Hsgngr/skygangsters-cad/previews/02_open_rear.png

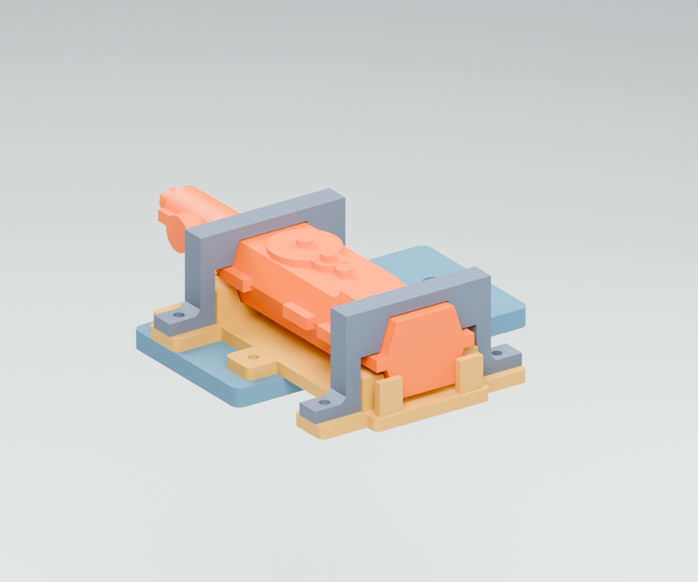
previews/02_open_rear.png
