Hsgngr/skygangsters-cad/previews/03_carrier_exploded.png

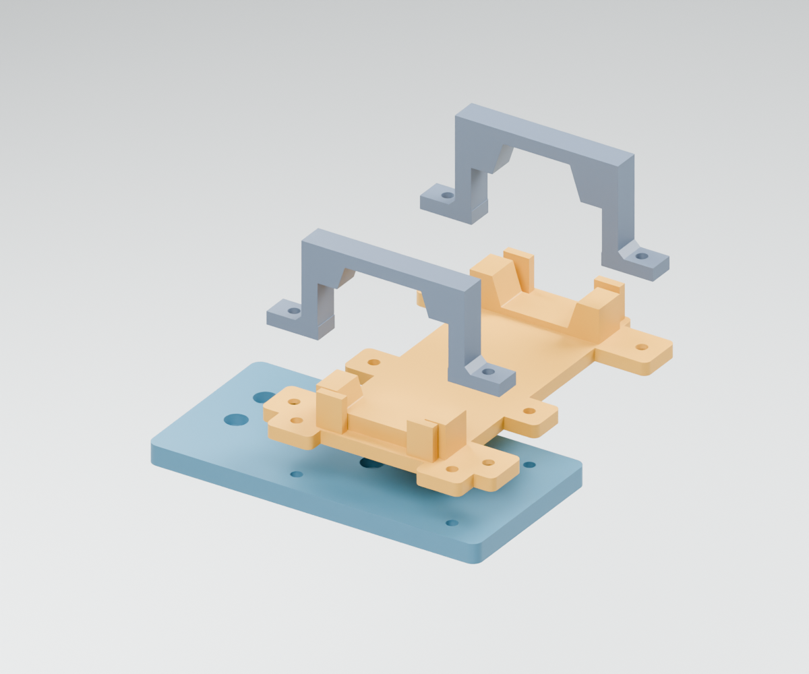
previews/03_carrier_exploded.png
