Hsgngr/skygangsters-cad/cad/latest/carrier_v4/assembly/front_bridge_assembly.stl

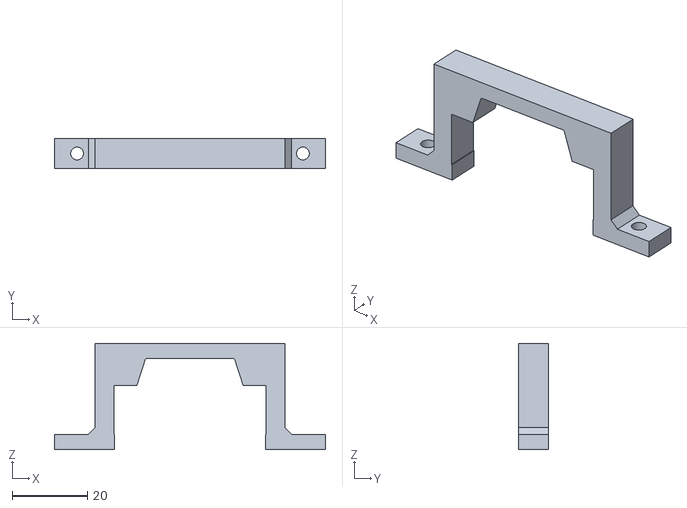
[picture p4: CAD file, 2026-09-30]
cad/latest/carrier_v4/assembly/front_bridge_assembly.stl
72.0 x 8.00 x 28.2
