Hsgngr/skygangsters-cad/cad/latest/carrier_v4/assembly/ptz_adapter_assembly.stl

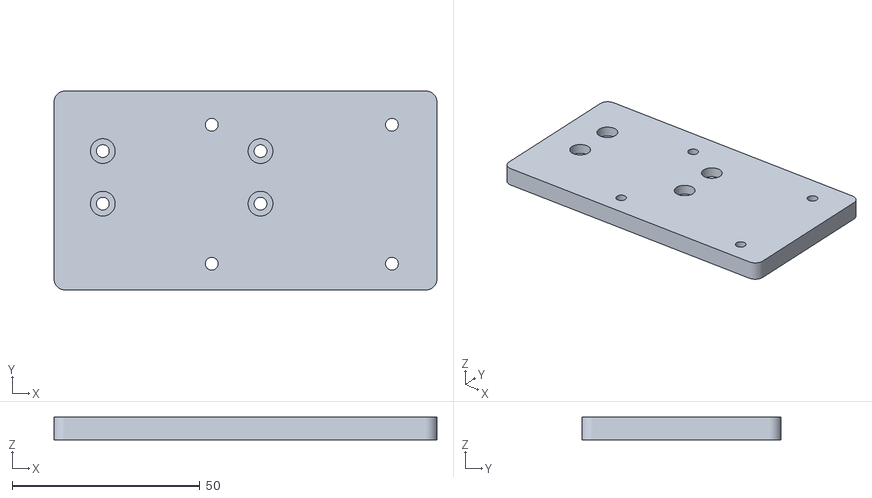
[picture p6: CAD file, 2026-09-30]
cad/latest/carrier_v4/assembly/ptz_adapter_assembly.stl
102.0 x 53.0 x 6.00
