Hsgngr/skygangsters-cad/cad/latest/carrier_v4/assembly/front_fit_saddle_assembly.stl

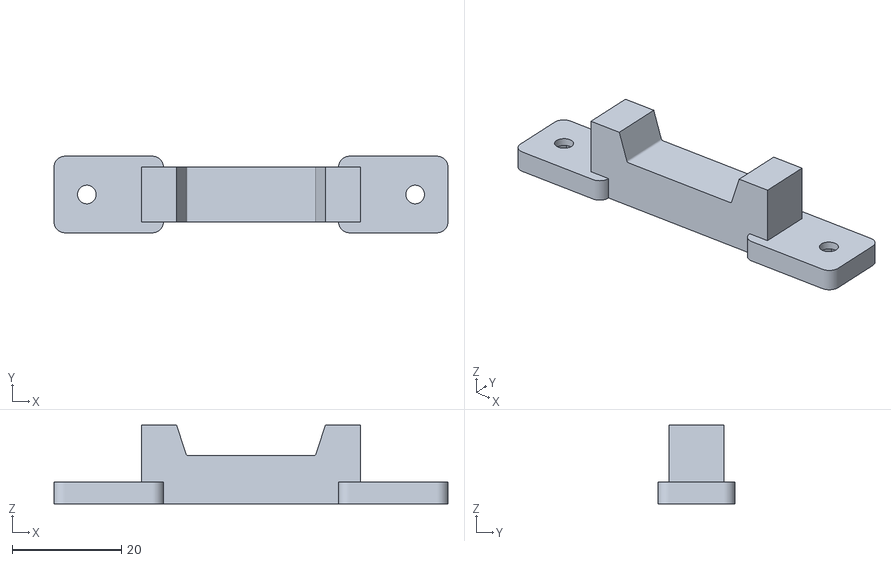
[picture p8: CAD file, 2026-09-30]
cad/latest/carrier_v4/assembly/front_fit_saddle_assembly.stl
72.0 x 14.0 x 14.4
