Hsgngr/skygangsters-cad/cad/latest/carrier_v4/assembly/gun_deck_assembly.stl

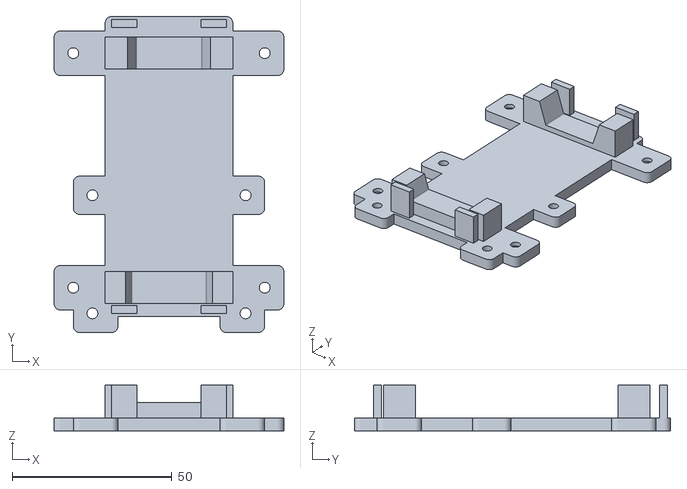
[picture p9: CAD file, 2026-09-30]
cad/latest/carrier_v4/assembly/gun_deck_assembly.stl
72.0 x 99.1 x 14.4
