Hsgngr/skygangsters-cad/cad/references/water_pump/water_pump.step

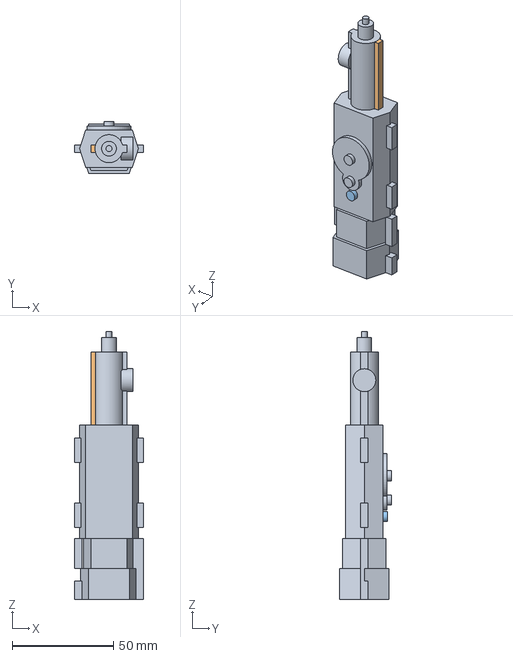
[picture p10: CAD file, 2026-09-30]
cad/references/water_pump/water_pump.step
34.0 x 25.4 x 132.1 mm
