Hsgngr/skygangsters-cad/cad/latest/carrier_v4/assembly/user_pump_body_2_reference.stl

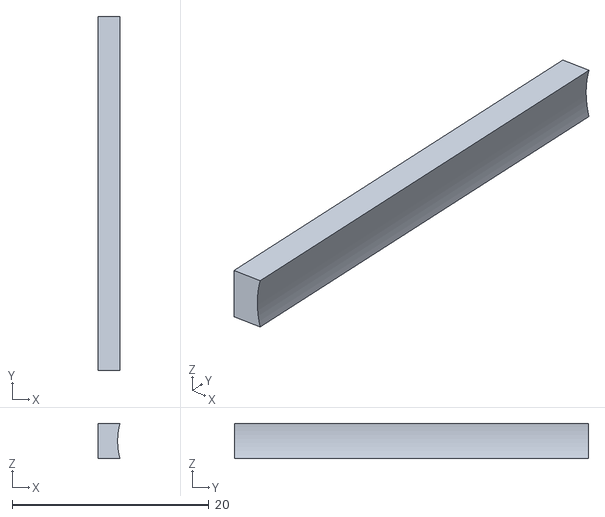
[picture p11: CAD file, 2026-09-30]
cad/latest/carrier_v4/assembly/user_pump_body_2_reference.stl
2.24 x 36.0 x 3.60
