Hsgngr/skygangsters-cad/print/coupons/ptz_top_pattern_test.stl

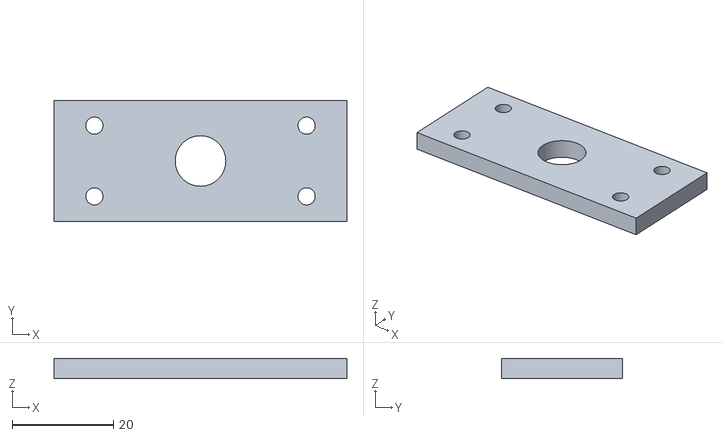
[picture p12: CAD file, 2026-09-29]
print/coupons/ptz_top_pattern_test.stl
58.0 x 24.0 x 4.00
