Hsgngr/skygangsters-cad/print/coupons/camera_hole_pattern_test.stl

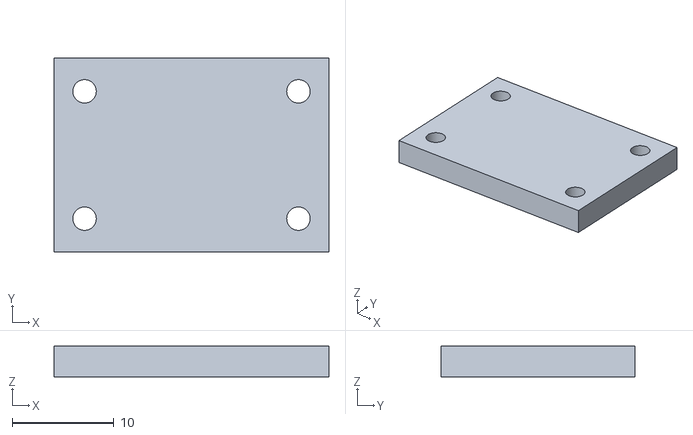
[picture p13: CAD file, 2026-09-29]
print/coupons/camera_hole_pattern_test.stl
27.0 x 19.0 x 3.00
