Hsgngr/skygangsters-cad/cad/latest/carrier_v4/assembly/ptz_tilt_reference.stl

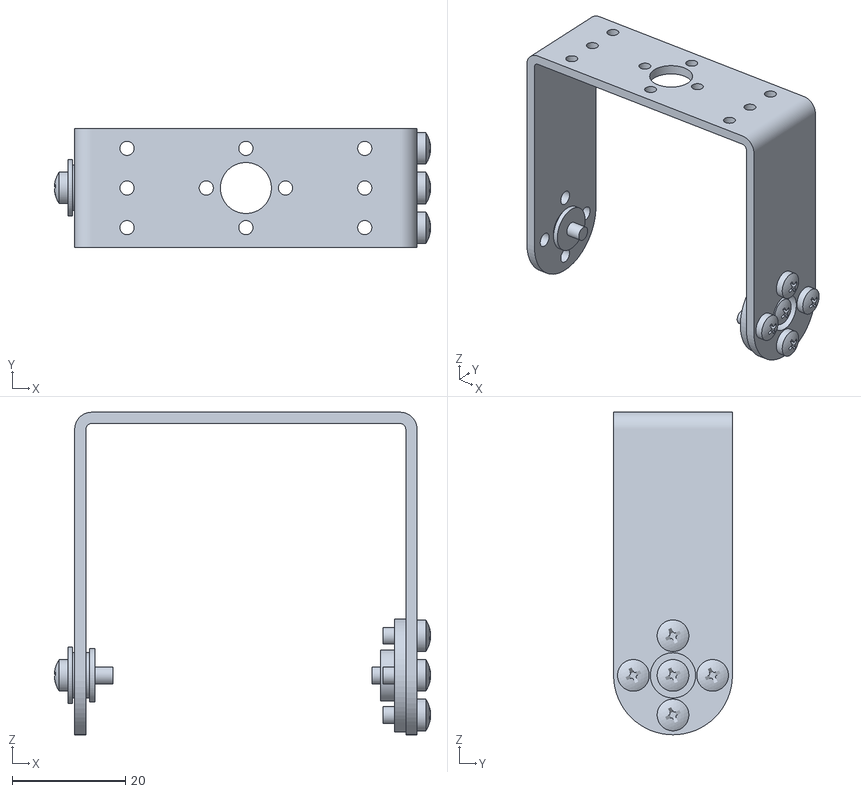
[picture p14: CAD file, 2026-09-30]
cad/latest/carrier_v4/assembly/ptz_tilt_reference.stl
66.4 x 21.0 x 57.0
