Hsgngr/skygangsters-cad/cad/latest/carrier_v4/assembly/carrier_v4_review.step

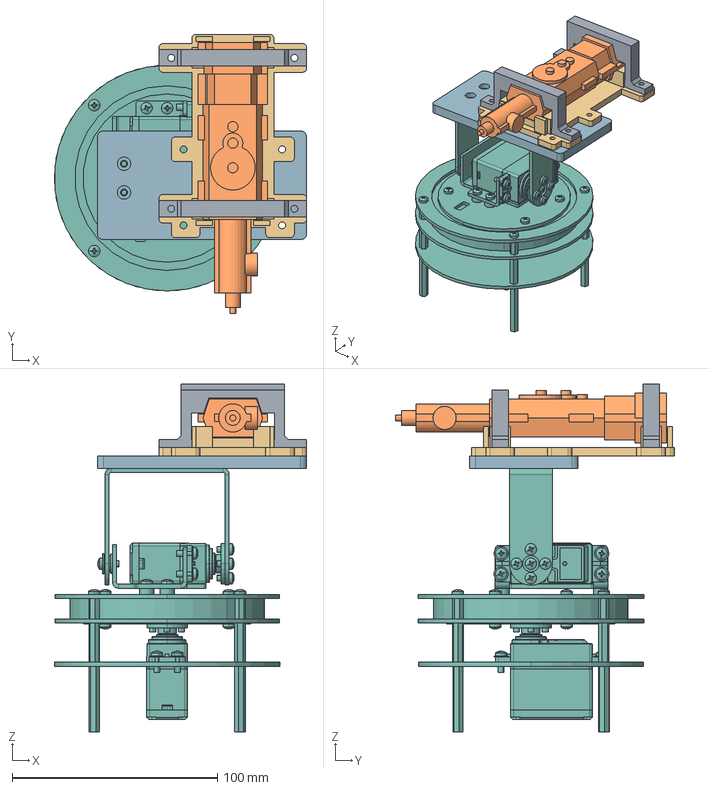
[picture p15: CAD file, 2026-09-30]
cad/latest/carrier_v4/assembly/carrier_v4_review.step
123.0 x 136.1 x 169.6 mm
ptz_adapter
gun_deck
rear_bridge
front_bridge
user_pump_body_1
user_pump_body_2
user_pump_body_3
ptz_fixed
ptz_pan
ptz_tilt
