Hsgngr/skygangsters-cad/cad/latest/carrier_v4/assembly/ptz_pan_reference.stl

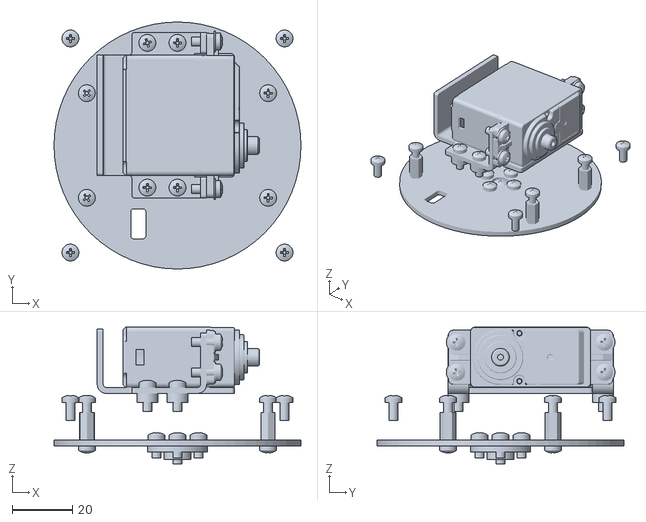
[picture p16: CAD file, 2026-09-30]
cad/latest/carrier_v4/assembly/ptz_pan_reference.stl
82.0 x 82.0 x 45.4
