Hsgngr/skygangsters-cad/cad/latest/carrier_v4/assembly/user_pump_body_3_reference.stl

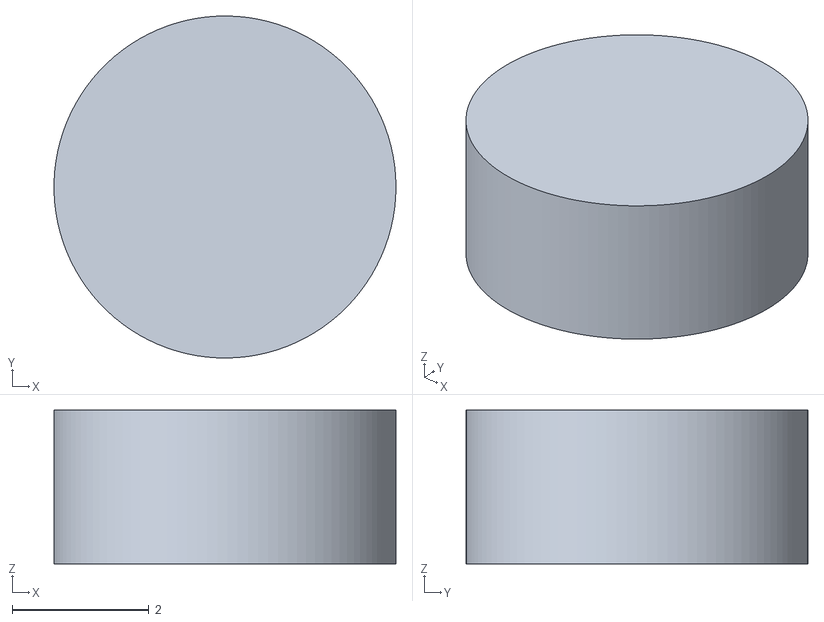
[picture p17: CAD file, 2026-09-30]
cad/latest/carrier_v4/assembly/user_pump_body_3_reference.stl
5.00 x 5.00 x 2.25
