Hsgngr/skygangsters-cad/cad/latest/carrier_v4/assembly/ptz_fixed_reference.stl

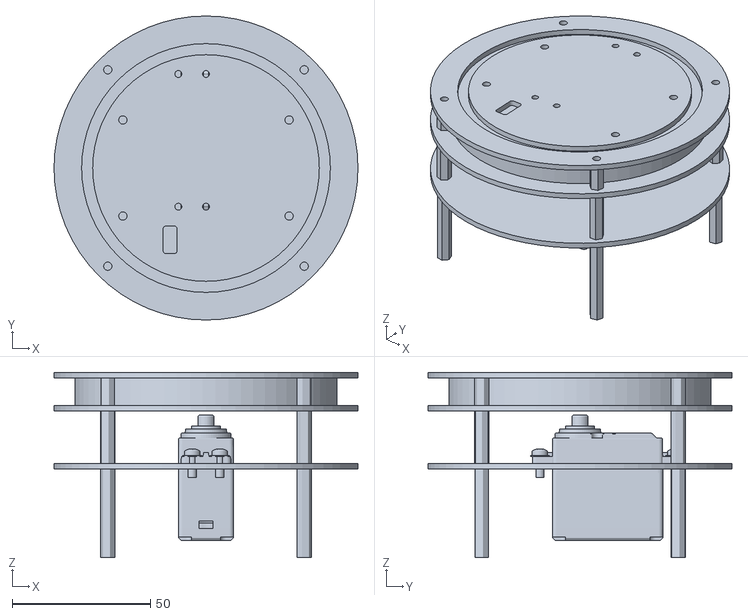
[picture p18: CAD file, 2026-09-30]
cad/latest/carrier_v4/assembly/ptz_fixed_reference.stl
110.0 x 110.0 x 67.0
