Hsgngr/skygangsters-cad/(list of files, cad)

Other CAD files:
cad/latest/carrier_v4/assembly/front_bridge.step
print/carrier/rear_fit_saddle_print.stl
print/carrier/front_bridge_print.stl
print/carrier/gun_deck_print.stl
print/carrier/rear_bridge_print.stl
print/carrier/ptz_adapter_print.stl
print/carrier/front_fit_saddle_print.stl
cad/latest/carrier_v4/assembly/rear_bridge.step
cad/latest/carrier_v4/assembly/front_fit_saddle.step
cad/latest/carrier_v4/assembly/user_pump_body_1_reference.stl
cad/latest/carrier_v4/assembly/gun_deck.step
cad/latest/carrier_v4/assembly/rear_fit_saddle.step
cad/latest/carrier_v4/assembly/ptz_adapter.step
print/coupons/m3_clearance_nut_test.stl
