Hsgngr/skygangsters-cad/(commit log)

2026-09-29 Publish current owl CAD snapshot, BOM and engineering handoff
    [camera_hole_pattern_test.stl, carrier_local.step, head_current_review.step, head_payload_carrier_v2_2.stl, m3_clearance_nut_test.stl, owl_current_review.step, ptz_top_pattern_test.stl, pump_reference.step]
2026-09-30 Document CAD toolchain and withdraw failed carrier print
2026-09-30 Publish STEP-derived V4 carrier prototype and reproducible handoff
    [carrier_local.step, carrier_v4_review.step, front_bridge.step, front_bridge_assembly.stl, front_bridge_print.stl, front_fit_saddle.step, front_fit_saddle_assembly.stl, front_fit_saddle_print.stl]
